tm-mech/diy-tensile-tester/(commit log)

2026-02-25 Add docs and calibration data
    [compliance_lookup.csv]
2026-02-25 added data files
    [PETG_522_001.CSV, PETG_533_003.csv, PETG_535_002.CSV, PLACF_520_001.csv, PLACF_520_003.csv, PLACF_530_002.csv, PLA_486_003.csv, PLA_524_002.csv]
